Tawakoll/active-ankle-prosthesis/media/hardware/annotated-actuation.png

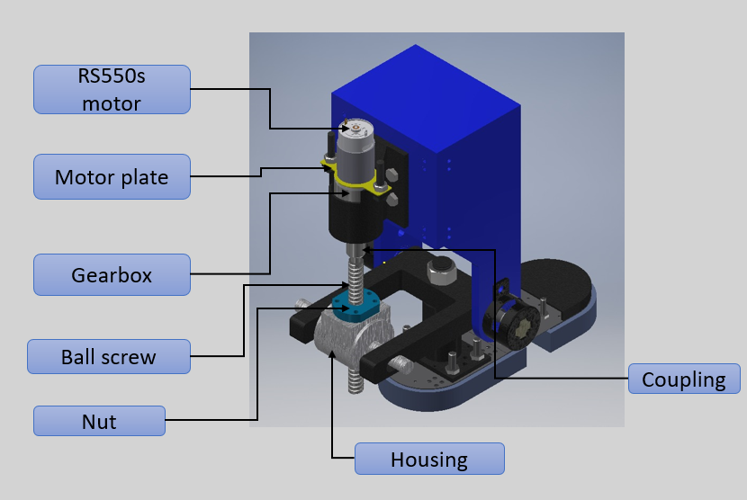
media/hardware/annotated-actuation.png
