Tawakoll/active-ankle-prosthesis/media/hardware/annotated-foot-exploded.png

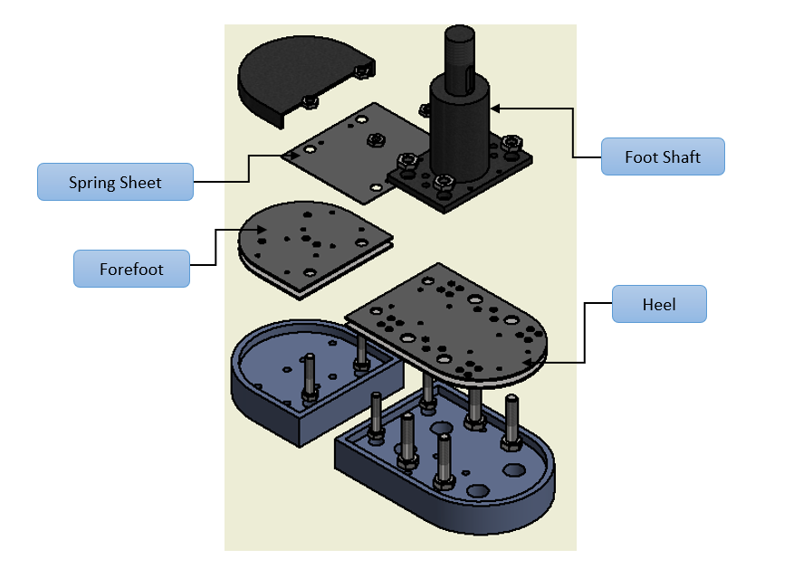
media/hardware/annotated-foot-exploded.png
