Tawakoll/active-ankle-prosthesis/docs/bill-of-materials.pdf

ITEM LIST

ITEM | PRICE | From | LINK
8xLoad cell | 81$=1275 EGP | Aliexpress Shipped in 7-15 days | https://www.aliexpress.com/item/32818770529.html?spm=a2g0o.placeorder .0.0.2f99321eVSAt YR&mp=1
AS5600 magnetic encoder | 90 EGP | FUTURE ELECTRONICS | https://store.fut-electronics.com/products/magnetic-enco der-rotary-position-sensor-as5600
hx711 | 60 EGP | FUTURE ELECTRONICS | https://store.fut-electronics.com/products/weight-scales-a nalog-to-digital-con verter-adc-24-bit?_ pos=1&_sid=ffa90 a15e&_ss=r
