Tawakoll/active-ankle-prosthesis/media/hardware/cad-assembly-annotated.png

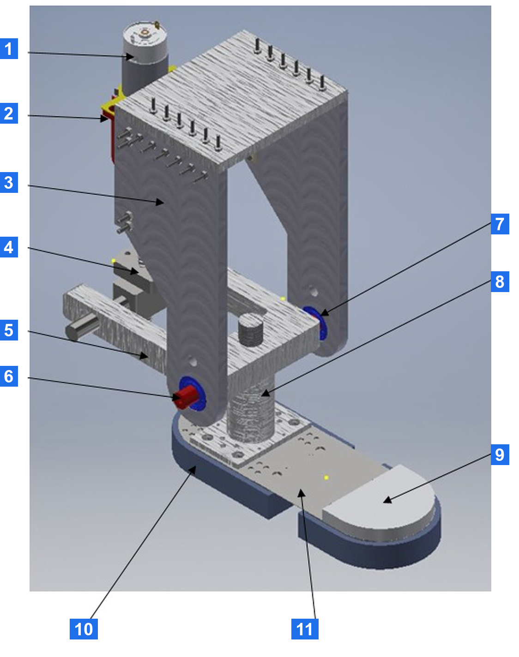
media/hardware/cad-assembly-annotated.png
