Tawakoll/active-ankle-prosthesis/media/hardware/wiring-diagram-esp32.png

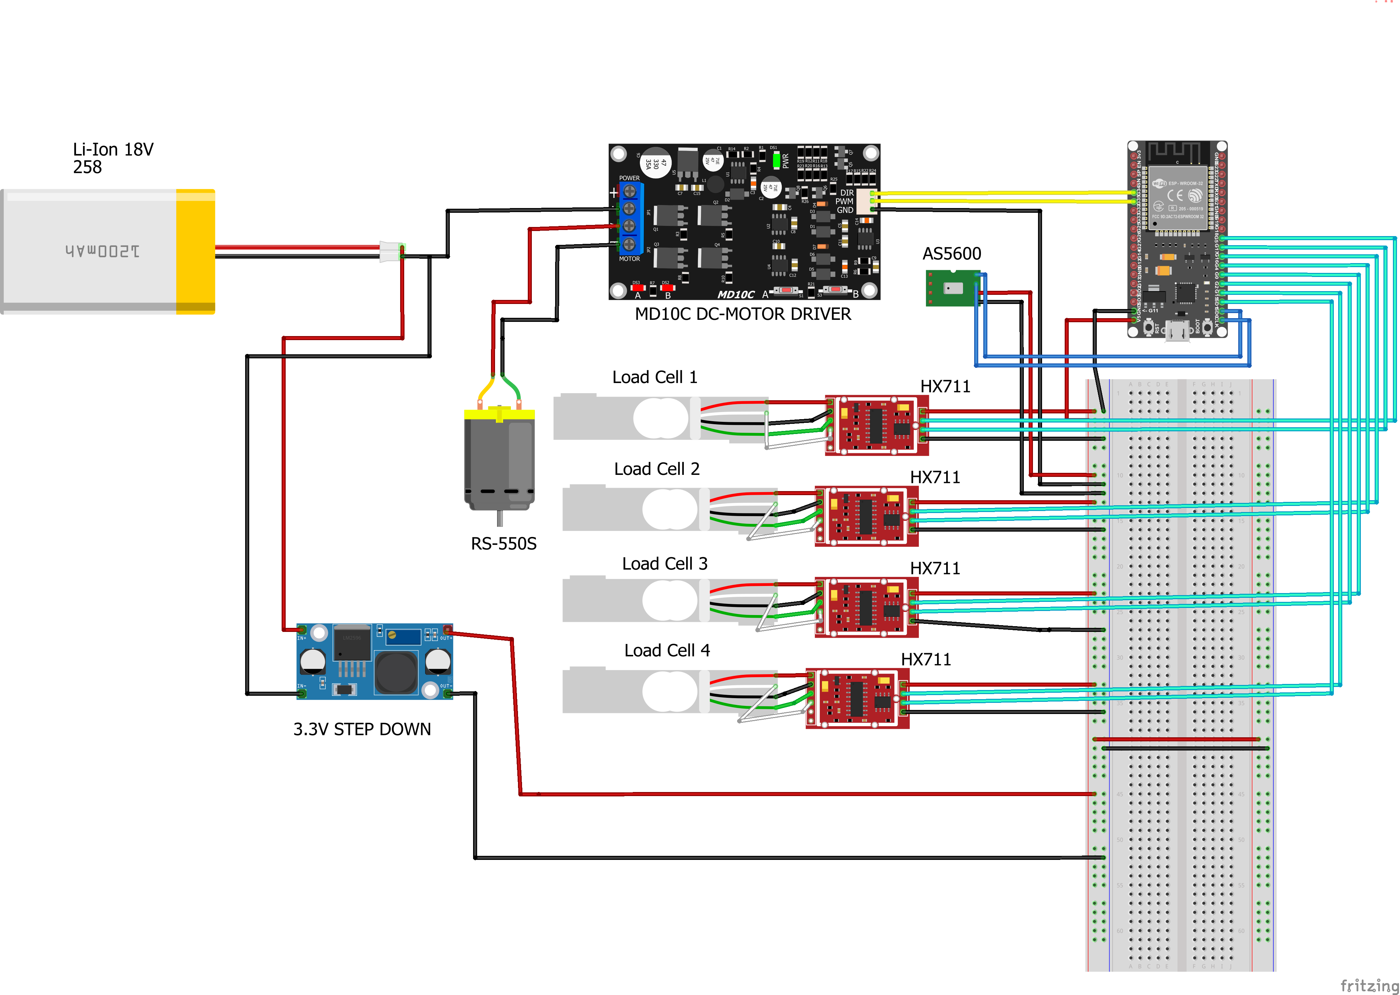
media/hardware/wiring-diagram-esp32.png
