Tawakoll/active-ankle-prosthesis/media/hardware/wiring-diagram-uno.png

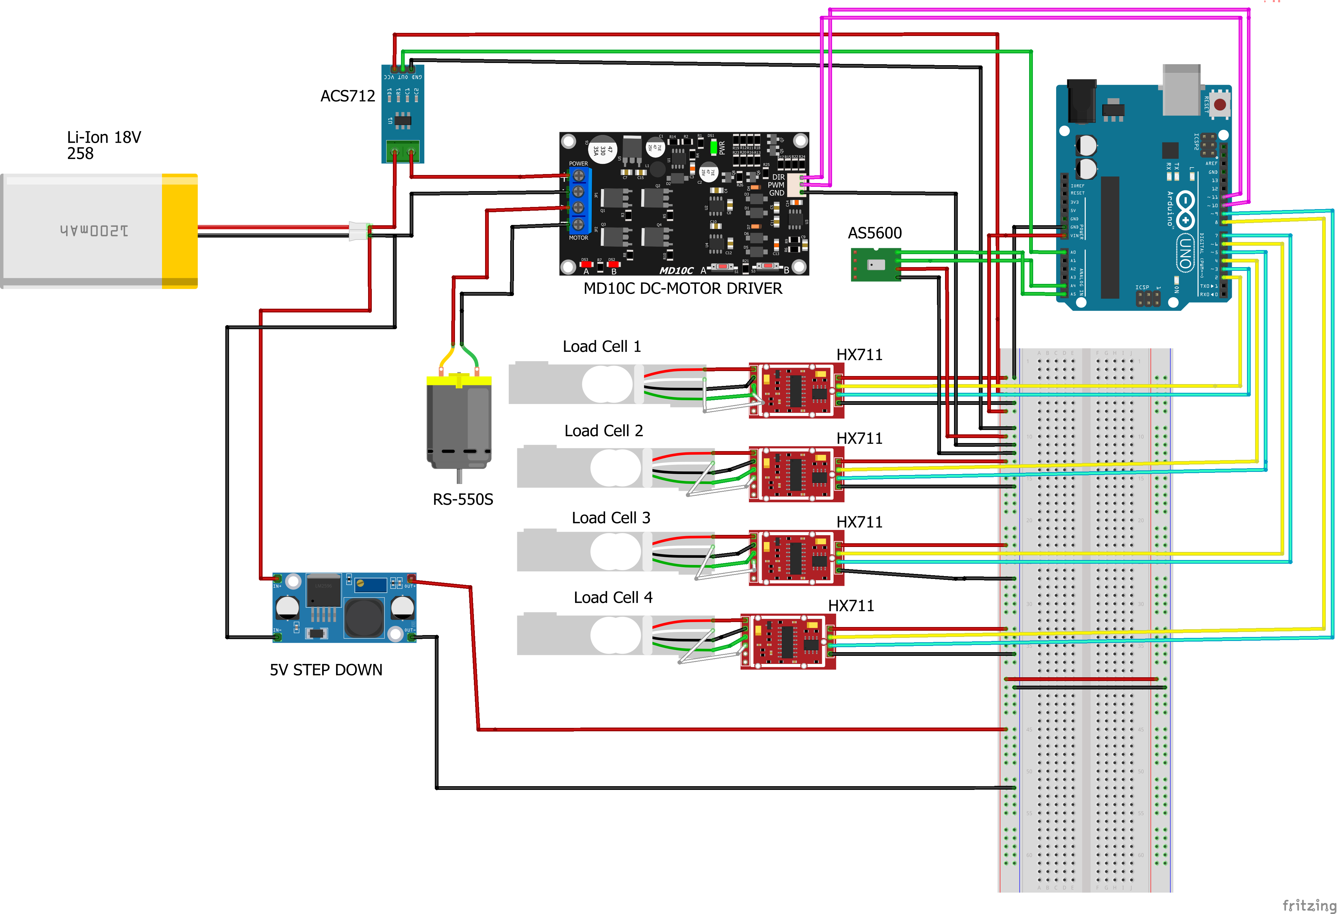
media/hardware/wiring-diagram-uno.png
