Tawakoll/active-ankle-prosthesis/firmware/original-sketches/ankle_controller_esp32/task6.ino

void toe_cells(void*) {

  VOID SETUP(){
     DELAY(10);
//     Serial.println();
//  Serial.println("Starting...");

float calibrationValue_1; // calibration value load cell 1
  float calibrationValue_2; // calibration value load cell 2

  calibrationValue_1 = 696.0; // uncomment this if you want to set this value in the sketch
  calibrationValue_2 = 733.0; // uncomment this if you want to set this value in the sketch
#if defined(ESP8266) || defined(ESP32)
  //EEPROM.begin(512); // uncomment this if you use ESP8266 and want to fetch the value from eeprom
#endif
  //EEPROM.get(calVal_eepromAdress_1, calibrationValue_1); // uncomment this if you want to fetch the value from eeprom
  //EEPROM.get(calVal_eepromAdress_2, calibrationValue_2); // uncomment this if you want to fetch the value from eeprom

  LoadCell_1.begin();
  LoadCell_2.begin();
  unsigned long stabilizingtime = 2000; // tare preciscion can be improved by adding a few seconds of stabilizing time
  boolean _tare = true; //set this to false if you don't want tare to be performed in the next step
  byte loadcell_1_rdy = 0;
  byte loadcell_2_rdy = 0;
  while ((loadcell_1_rdy + loadcell_2_rdy) < 2) { //run startup, stabilization and tare, both modules simultaniously
    if (!loadcell_1_rdy) loadcell_1_rdy = LoadCell_1.startMultiple(stabilizingtime, _tare);
    if (!loadcell_2_rdy) loadcell_2_rdy = LoadCell_2.startMultiple(stabilizingtime, _tare);
  }
  if (LoadCell_1.getTareTimeoutFlag()) {
//    Serial.println("Timeout, check MCU>HX711 no.1 wiring and pin designations");
  }
  if (LoadCell_2.getTareTimeoutFlag()) {
//    Serial.println("Timeout, check MCU>HX711 no.2 wiring and pin designations");
  }
  LoadCell_1.setCalFactor(calibrationValue_1); // user set calibration value (float)
  LoadCell_2.setCalFactor(calibrationValue_2); // user set calibration value (float)
//  Serial.println("Startup is complete");
    
    }
  VOID LOOP() {
    static boolean newDataReady = 0;
    const int serialPrintInterval = 0; //increase value to slow down serial print activity

    // check for new data/start next conversion:
    if (LoadCell_1.update()) newDataReady = true;
    LoadCell_2.update();

    //get smoothed value from data set
    if ((newDataReady)) {
      if (millis() > t + serialPrintInterval) {
        float front_weight = LoadCell_1.getData() + LoadCell_2.getData();
        if(front_weight >=threshold){ toe_state=true;}
        else {toe_state=false;}

       
//        Serial.print("Load_cell 1 output val: ");
//        Serial.print(a);
//        Serial.print("    Load_cell 2 output val: ");
//        Serial.println(b);
        newDataReady = 0;
        t = millis();
      }
    }

    // receive command from serial terminal, send 't' to initiate tare operation:
    if (Serial.available() > 0) {
      char inByte = Serial.read();
      if (inByte == 't') {
        LoadCell_1.tareNoDelay();
        LoadCell_2.tareNoDelay();
      }
    }

    //check if last tare operation is complete
    if (LoadCell_1.getTareStatus() == true) {
//      Serial.println("Tare load cell 1 complete");
    }
    if (LoadCell_2.getTareStatus() == true) {
//      Serial.println("Tare load cell 2 complete");
    }



  }

}
