Tawakoll/active-ankle-prosthesis/(commit log)

2026-09-16 Re-enable contact-triggered gait-phase tasks in final ESP32 build
    The archived shimi.ino had task6 (toe_cells) and task7 (heel_cells)
    commented out in setup(). Load-cell gait-phase detection was
    demonstrated on hardware; the tasks were disabled during a test session
    and the file was saved in that state.
    Re-enabling them restores the intended final configuration: the
    trajectory generator advances on detected gait phase rather than on a
    fixed timer. The previous commit preserves the archived state.
2026-09-16 Add actuator and BOM tables, expand README with build photos
    Pull the real actuator specs out of the graduation book: RS-550S brushed
    DC motor salvaged from a cordless drill, Cytron MD10C H-bridge, SFU1605
    ball screw, SKF 6002 bearing, 18 V Li-ion pack. Add the 2021 bill of
    materials with prices, which is the point of the affordability argument.
    Show both Fritzing wiring diagrams, Arduino Uno and ESP32, since together
    they document the board migration the book never recorded. Lead with the
    photo of the assembled prosthesis and add a PID step response.
    Remove media/hardware/ankle-range-of-motion.jpg: it is a copyrighted
    clinical gait figure, not the team's own work.
2026-09-16 Rename firmware folders to describe what they contain
    The folders carried working names from 2021 that mean nothing to a
    reader: shimi, trial_code, esp32-final. Rename them for what they are,
    and rename each main sketch to match its folder so the Arduino IDE still
    opens them:
    shimi/ -> ankle_controller_esp32/
    trial_code/ -> loadcell_bench_esp32/
    arduino-avr/-> development_avr/
    Also drop the README note claiming the folder was named after a
    teammate. It was not.
2026-09-16 Port the ESP32 controller to plain C++ sources and archive the sketches
    The .ino format hid the structure: one file held every global, and the IDE
    generated the prototypes. Unwind that into ordinary translation units, one
    task per file, with shared state declared in include/config.h and defined
    once in main.cpp. Add a platformio.ini so it builds outside the IDE.
    Behaviour is unchanged. The port adds includes and prototypes, nothing else.
    The sketches move to firmware/arduino-ide-originals/ as written in 2021,
    with one exception noted below.
    Restore the gait-phase state machine in TrajGen. The live path was a plain
    timed sweep and the contact logic sat commented out beneath it, so the
    load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
2026-09-16 Play down the toolchain in the documentation
    The IDE was a means to an end, not a feature of the project, and naming it
    in every other paragraph made it read like one. Keep the single note
    explaining why it was chosen, and the one place the graduation book's board
    mismatch has to be quoted, and drop the rest.
    arduino-ide-originals/ -> original-sketches/
    wiring-diagram-arduino-uno.png -> wiring-diagram-uno.png
    "the Arduino plotter" -> "the serial plot" / "the output plot"
2026-09-16 Split the parts list by category and document the test bench
    Break the single price table into Actuation, Sensing and Control, and
    point at the bill of materials for the mechanical parts rather than
    implying the list is complete.
    Add the development history that the folder names were hiding. The AVR
    sketches are not abandoned drafts: they are a motor test bench built
    while the ankle was still being machined, and they run in a legible
    sequence from reading the encoder, through driving it with the H-bridge,
    to a tuned PID under an RTOS. The loop was tuned and the gains known
    before the assembled ankle existed.
    development_avr/ -> motor-test-bench/
    Correct the note on FINAL_PID_CODE_WITH_R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
2026-09-16 Fold the parts list into a Components section and drop the prices
    A repository is not a storefront, and a column of Egyptian pound figures
    read like one. Remove the pricing section entirely and keep what a reader
    actually needs: what the part is and what it does.
    Add a Control electronics subsection, which the pricing tables had left
    out. The ESP32 was the controller on the assembled ankle and was not
    listed anywhere in the components at all; the ATmega328 board is named
    for what it was, the test bench controller.
    The machine -> Components (Actuation, Sensing, Control electronics, Wiring)
    Control -> Control system
2026-09-16 Make the component tables consistent and separate specs from parts
    All three component tables now use the same Part / Role schema. The
    Actuation table had been mixing parts with motor datasheet rows, so the
    figures move to their own Property / Value table, attributed to the
    graduation book.
    Also corrected:
    - ACS712 is listed as first-design and test-bench only. It appears in
    neither the final ESP32 wiring diagram nor any ESP32 source.
    - read_ANGLE no longer described as converting to degrees. That line is
    commented out in the ESP32 build, which runs on raw counts.
    - The subtitle no longer claims a fraction of commercial cost, which
    nothing in the repository measures.
2026-09-16 Add a system overview and fold the detail into collapsible sections
    The README described the parts before it described the loop, so a reader
    met a components table without knowing what the machine does. Add a How
    it works section above Components: a mermaid block diagram of the closed
    loop, and four numbered steps from foot contact through to the encoder.
    Show the remaining bench media. All three PID step responses are now in
    the README rather than one, and the ACS712 trace is included with the
    figures it actually shows.
    Collapse the tuning sweep, the current sensing and the bench sketch table
    behind details blocks so the main flow stays short.
2026-09-16 Re-annotate the figures, add the bench photo, halve image widths
    Lead with the CAD assembly instead of the bench photograph: it shows what
    the machine is. The original render carried its labels in a white margin
    with crossing leader lines and inconsistent capitalisation, so crop to the
    render, keep the existing arrows, and put numbered callouts at the arrow
    tails with the names in a markdown table. The part names become selectable
    text and stay readable at half width.
    Add the motor test bench photograph, cropped off the desk clutter and
    levelled, with callouts for the motor, ball screw, driver, board and
    battery. It illustrates the section that until now had no picture.
    Correct the demo se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
2026-09-16 Use the presentation figures: built ankle, turntable, exploded views
    The final presentation carried a properly lit photo set of the finished
    ankle and professionally annotated CAD views, none of which were in the
    repository. They are better than anything the book had.
    Pair the annotated CAD with the photograph of the built ankle at the top,
    labelled as designed and as built, so the first thing a reader sees is
    both the intent and the result.
    Add the CAD turntable from slide 30 as a GIF, cropped to remove the
    clideo.com watermark left by the converter used in 2021, and recompressed
    from 5.8 MB to 2.4 MB.
    Add the two annotated exploded views to the Actuation section: the motor,
    gearbox, bal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
2026-09-16 Lead with the rotating CAD beside the photograph
    The turntable render is painted the same blue as the finished ankle, so
    the two sit together as one image: the design turning on the left, the
    machine it became on the right. Putting it at the top says more in a
    glance than a static grey render did.
    Move the annotated render and its part legend down to Actuation, where
    the mechanism is described.
2026-09-16 Replace the demo photograph with the electronics bay shot
    The old photograph was dark and shot against a cluttered desk. This one
    has the side panel off, so the 18 V battery, the driver and regulator
    boards and the wiring loom down to the ball screw are all visible, which
    is what the surrounding text describes. Caption corrected to match what
    the picture actually shows.
2026-09-16 Show the ankle three ways at the top, panel-off view annotated
    The title block now runs design, built, and opened up: the CAD turntable,
    the finished ankle closed, and the same ankle with its side panel off so
    the battery, boards and wiring are visible. Numbered callouts name what
    is inside.
    Mirror the panel-off photograph. It was shot from the opposite side, so
    the foot pointed away from the other two; flipped, all three face the
    same way and read as one object. The wall stencil behind it is reversed
    as a result.
2026-09-19 Unify title-image sizes, fix badge contrast, complete the annotation, rebuild How it works from the presentation
    Title block: set a common display height on all three images instead of
    mismatched percentages, so the row reads as one unit rather than three
    oddly-sized panels.
    Electronics-bay photo: badges were blue on a blue-painted frame, nearly
    unreadable. Switched to high-contrast orange. Went from 6 labelled
    components to 8, after zooming into each one rather than guessing:
    battery, power connector, a small regulator board off the battery leads
    (left unidentified rather than guessed, since it does not match the
    presentation's own LM2596 reference photo), the RS-550S motor, the HX711
    ampl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
2026-09-19 Show the physical feedback taps, confirm no current-sensor loop, unify title-image pixel dimensions, trim process narration
    Redrew the control-loop diagram so the feedback lines show where each
    signal actually comes from rather than floating in from a box: a dotted
    line from the ankle joint into the encoder (it senses the shaft the motor
    turns), and a dotted line from the ground into the strain gauges (they
    read the reaction force coming back up through the foot).
    Re-checked the firmware end to end for any current-sensor feedback path.
    Confirmed: the ACS712 is read in exactly two places, both standalone bench
    sketches under motor-test-bench/ used only to characterise the motor. It
    is absent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
2026-09-20 Split the DC motor PID tuning bench into its own repo
    The bench work (motor, H-bridge, encoder, PID tuning, current sensing) now
    lives at github.com/Tawakoll/dc-motor-pid-tuning-bench. Replace the
    "test bench came first" section with a short pointer, remove the migrated
    firmware sketches and media, and add the top-of-page feature summary,
    move the annotation off the "side panel off" photo into the Actuation
    section, and place the trajectory plot ahead of the results section.
2026-09-20 Split the panel-off photo, swap the control diagram for the presentation's original
    The title-block "side panel off" photo carried orange callout badges baked
    into the pixels. Split it: a clean, unannotated version for the title row,
    and the annotated version (higher resolution too) moved into the
    Actuation section where the numbered legend already lives.
    Replace the Mermaid recreation of the control loop with the team's actual
    control-strategy diagram from the presentation (slides 32/36), at the
    user's choice. Patched only the one spelling error ("SESNORS" ->
    "SENSORS") by matching the box's fill colour and redrawing the word nothing
    else in the diagram was touched.
2026-09-20 Remove the gait-cycle phase diagram
    Dropped, not replaced. The Mermaid version was too elaborate for what it
    said, and no real alternative was worth the trade: the only non-copyrighted
    presentation diagram covering the same ground added a second flowchart
    right next to the one already kept, and the timing figures it carried
    duplicate what Limitations already states.
2026-09-20 Cut the README to essentials: drop the plot-only demo, team, licence and repo-map sections, compact the components table
    Add a Project Description heading over the feature bullets, replacing the
    one-liner and duplicate sponsorship line that just repeated them in prose.
    Replace the plot-only gait-cycle demo with real footage: a hand actuating
    the ankle joint through the ball screw while the live PID trace updates on
    screen, recovered from Drive (see conversation) and converted to a GIF.
    The old screen-only recording, its GIF, and the still frame standing in
    for the video that never turned up are now orphaned by this swap and are
    removed along with it.
    Collapse the four Components subsection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
